Gernreich/octagonal-flute/step/octagonal-flute-octagonal-flute-d4.step

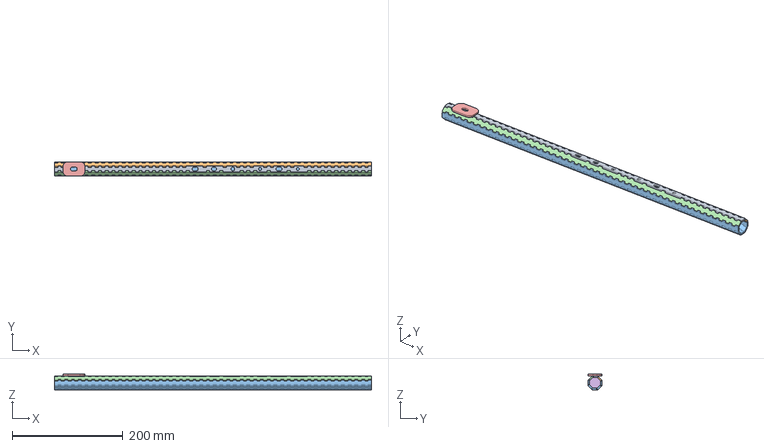
[picture p1: CAD file, 2026-11-08]
step/octagonal-flute-octagonal-flute-d4.step
571.9 x 26.0 x 28.0 mm
