Gernreich/octagonal-flute/(commit log)

2026-10-18 A six-hole transverse flute in D, its bore a long octagon of finger-jointed ply
    Eight walls the flute's length, joined at 135 degrees by the four-hole
    ocarinas' polyhedron joint; the top keeps its edges beside every opening.
    A lip plate over the embouchure makes a 6mm chimney; the cork is three
    press-fit discs; the foot is cut 25mm long to trim to pitch. Holes laid
    out 34mm apart within a hand, sizes solved, slots where wider than the wall.
2026-10-19 Run --heard before trimming; the bed's limit on a redraw; the bed check counts the kerf
2026-10-19 Bed is 600 x 305mm, cut-tested
    The largest rectangle the xTool P2S cut, tested 2026-10-19, is 600 x 305mm,
    not the 600 x 308 assumed here until now.
2026-10-22 Link back to all projects at the top of the README and the page
    The rest of the build files now points at lasermademusic.html, where the
    instruments moved when the root page became a directory.
2026-11-07 Call lasermade-tools' Rust programs, not its Python scripts
    The tools became Rust on 2026-11-07: target/release/<name> in lasermade-tools
    (cargo build --release there) replaces python3 <name>.py, in commands,
    manifests and prose. Pages rebuilt; no generated file changes otherwise.
2026-11-08 The generators are Rust: octagonal_flute, flute_model (with --bores for bore-tmm), page_assets; the cut file, plans and page byte for byte the same
2026-11-08 Cargo.lock: bore-tmm now depends on lasermade-tools and roxmltree
2026-11-08 STEP files of the 3D view, for a CAD program
    One file per design in step/, one solid body per part, written from the
    3D page by lasermade-tools step-export and checked by .repro. Every file
    opens in SolidCraft with every body closed and no warnings.
2026-11-08 The flute as a parametric SolidCraft design, its .sc, and the STEP file built by SolidCraft
    solidcraft.rs (octagonal_flute --solidcraft=DIR): ply, bore, head, cork, lip plate
    and openings as expressions; the joints re-counted along the walls, the top keeping
    its edges round every opening wherever it moves. The tuning stays the solver's, as
    parameters. Matches the generator's parts to 0.012 mm, also with the holes moved.
